dinvincible98/MAE172-Card-shuffler/README.md

# MAE172-Card-shuffler
This is the final project for MAE172 at UC Irvine.For detailed information about CAD design, circuit design and code, please view the final report.
