dinvincible98/MAE172-Card-shuffler/CAD/Assembly/Motor& Roller Assembly.SLDASM

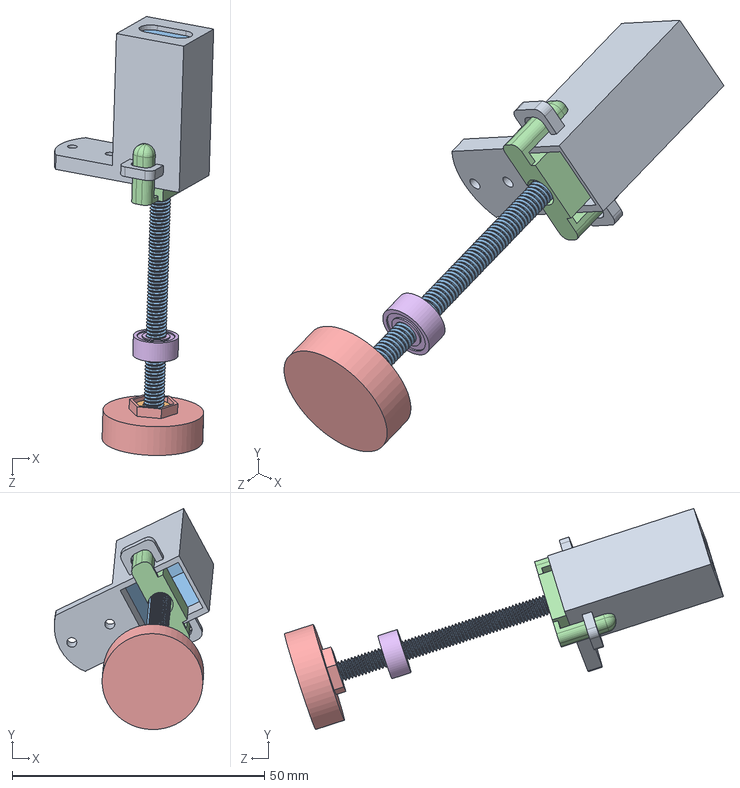
[picture p22: CAD file, 2021-01-10]
CAD/Assembly/Motor& Roller Assembly.SLDASM
31.6 x 43.8 x 87.1 mm
M4 Nut
New Motor
New Motor case2
New Motor enclosure
New Motor roller
Bearing
