dinvincible98/MAE172-Card-shuffler/CAD/Assembly/poker case assembly 2.SLDASM

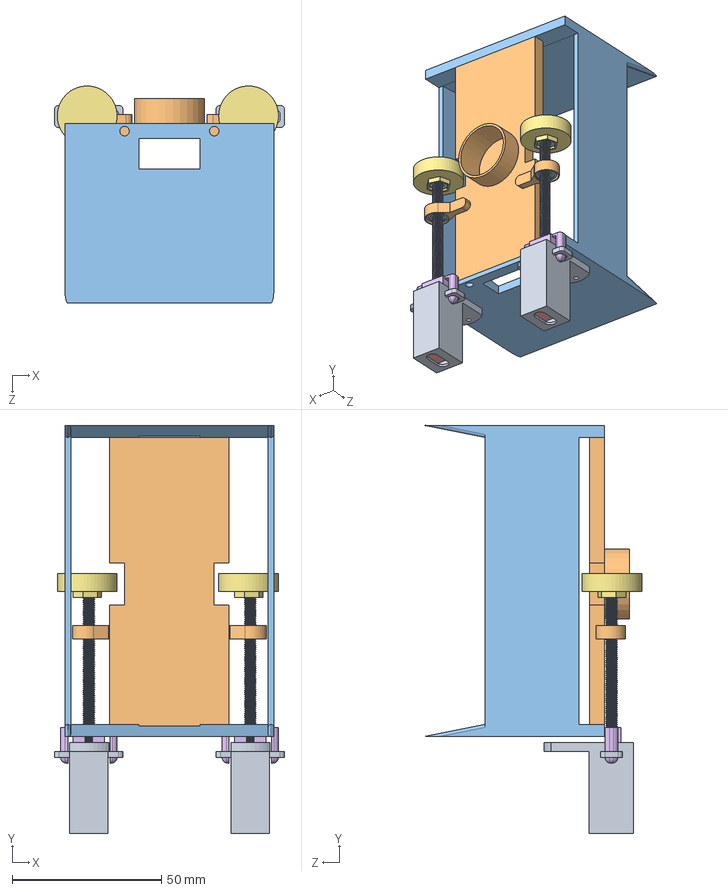
[picture p23: CAD file, 2021-01-10]
CAD/Assembly/poker case assembly 2.SLDASM
77.0 x 136.5 x 72.6 mm
poker case base 1
poker case base 2
M4 Nut x 2
New Motor x 2
New Motor case2 x 2
New Motor enclosure x 2
New Motor roller x 2
Bearing x 2
