dinvincible98/MAE172-Card-shuffler/CAD/Assembly/side platform assembly (right).SLDASM

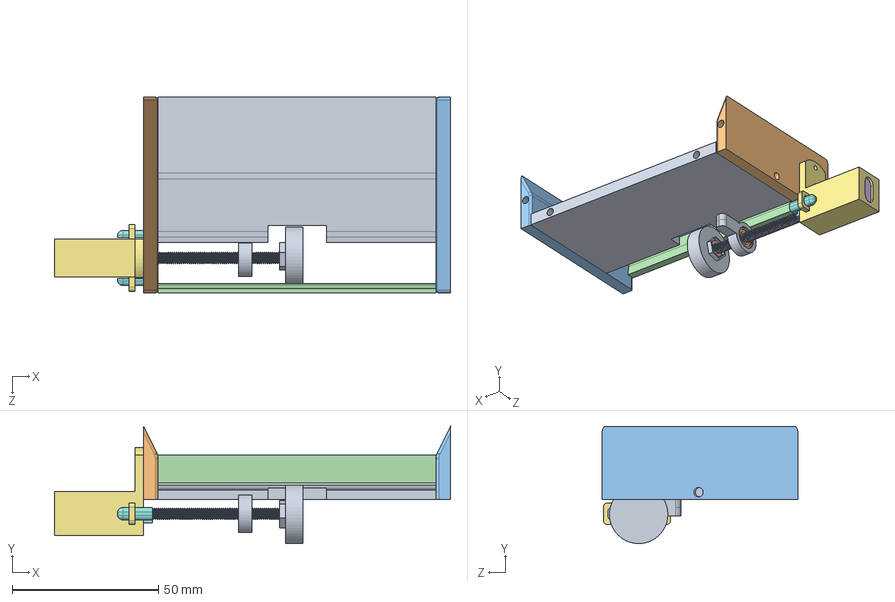
[picture p24: CAD file, 2021-01-10]
CAD/Assembly/side platform assembly (right).SLDASM
135.5 x 40.1 x 67.0 mm
Poker plate (right)
Poker plate2(right)
Poker plate2.2(right)
Poker plate3.1
M4 Nut
New Motor
New Motor case2
New Motor enclosure
New Motor roller
Bearing
