dinvincible98/MAE172-Card-shuffler/CAD/Assembly/base &elevator.SLDASM

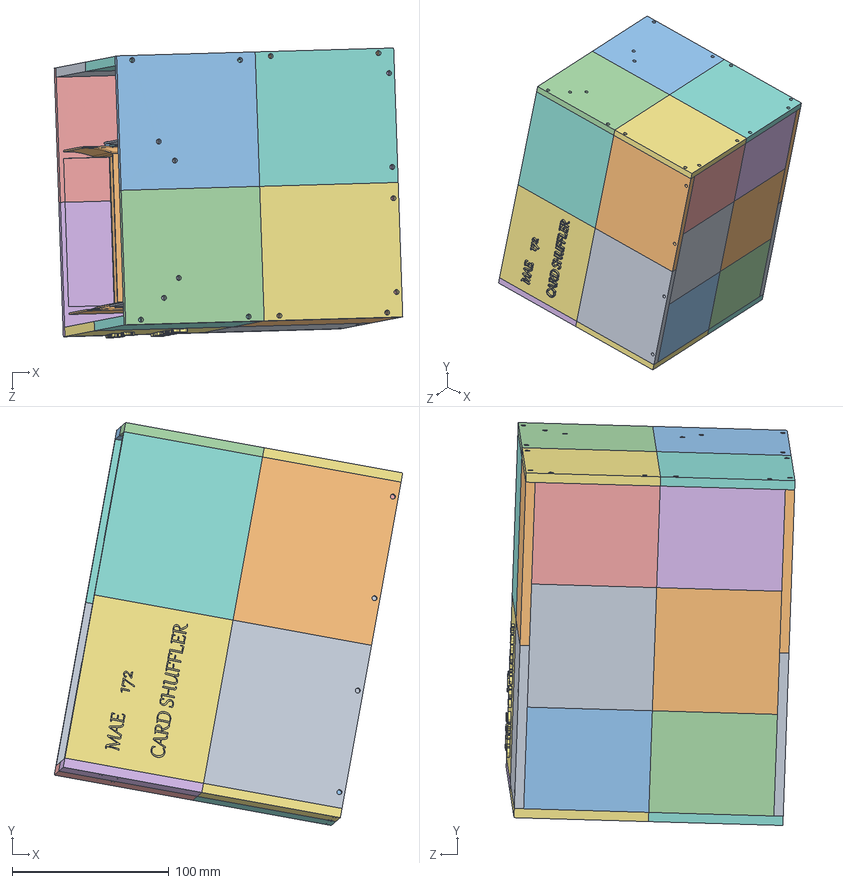
[picture p25: CAD file, 2021-01-10]
CAD/Assembly/base &elevator.SLDASM
222.7 x 257.5 x 185.3 mm
7mm base plate
7mm base plate 2
7mm base plate 3
7mm base plate 4
7mm base plate 5
7mm base plate 6
6mm side plate1 x 2
6mm side plate2 x 2
6mm back plate1 x 2
6mm back plate2( back)
6mm side plate3(right)
6mm side plate4(right)
6mm side plate3
6mm side plate4
6mm back plate3( front)
6mm back plate4 x 2
6mm back plate3( back)
6mm back plate2
rack platform V3
rack base V5
spur gear_am
rack spur rectangular_am
poker case base 1
poker case base 2
M4 Nut x 4
New Motor x 4
New Motor case2 x 4
New Motor enclosure x 4
New Motor roller x 4
Bearing x 4
motor
motor enclosure
right platform
left platform
IRsemsor x 2
