dinvincible98/MAE172-Card-shuffler/CAD/Assembly/poker case assembly.SLDASM

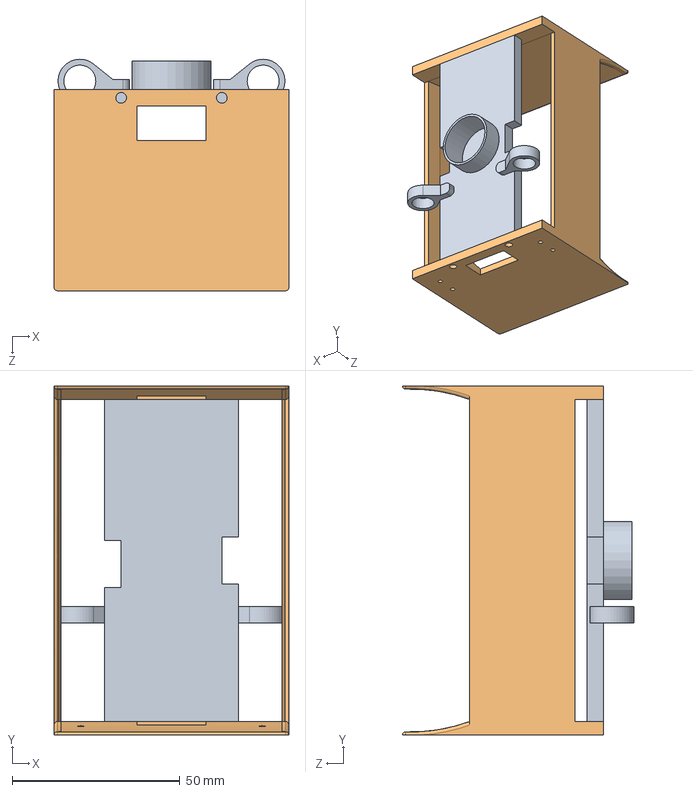
[picture p26: CAD file, 2021-01-10]
CAD/Assembly/poker case assembly.SLDASM
70.0 x 104.0 x 69.0 mm
poker case base 1
poker case base 2
