dinvincible98/MAE172-Card-shuffler/CAD/Assembly/side platform assembly (left).SLDASM

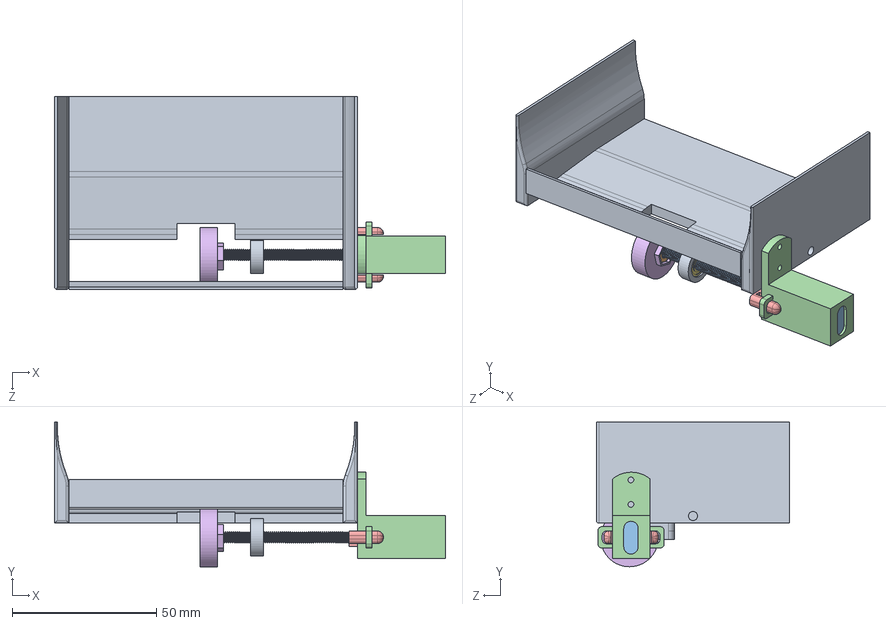
[picture p27: CAD file, 2021-01-10]
CAD/Assembly/side platform assembly (left).SLDASM
135.5 x 50.1 x 67.0 mm
left platform
M4 Nut
New Motor
New Motor case2
New Motor enclosure
New Motor roller
Bearing
