dinvincible98/MAE172-Card-shuffler/CAD/Assembly/right platform assembly (right).SLDASM

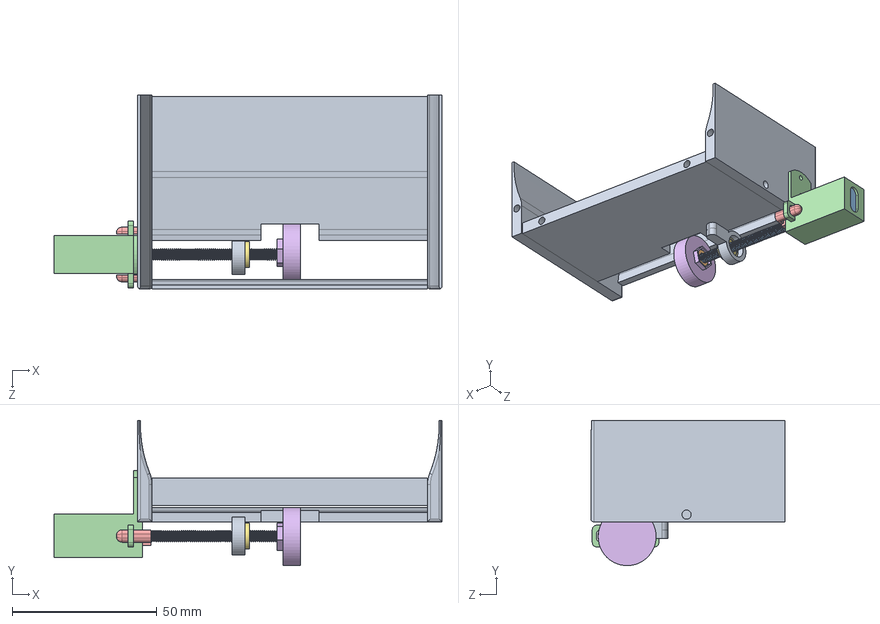
[picture p28: CAD file, 2021-01-10]
CAD/Assembly/right platform assembly (right).SLDASM
133.8 x 50.1 x 67.0 mm
right platform
M4 Nut
New Motor
New Motor case2
New Motor enclosure
New Motor roller
Bearing
