dinvincible98/MAE172-Card-shuffler/CAD/Assembly/1.SLDASM

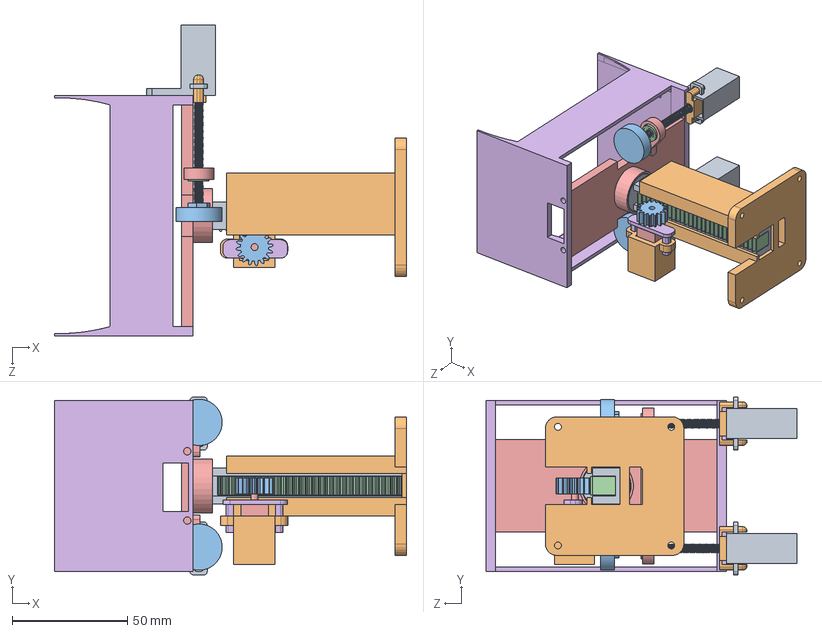
[picture p29: CAD file, 2021-01-10]
CAD/Assembly/1.SLDASM
152.4 x 77.0 x 134.5 mm
rack platform V3
rack base V5
spur gear_am
rack spur rectangular_am
poker case base 1
poker case base 2
M4 Nut x 2
New Motor x 2
New Motor case2 x 2
New Motor enclosure x 2
New Motor roller x 2
Bearing x 2
motor
motor enclosure
