dinvincible98/MAE172-Card-shuffler/CAD/Assembly/Elevator assembly.SLDASM

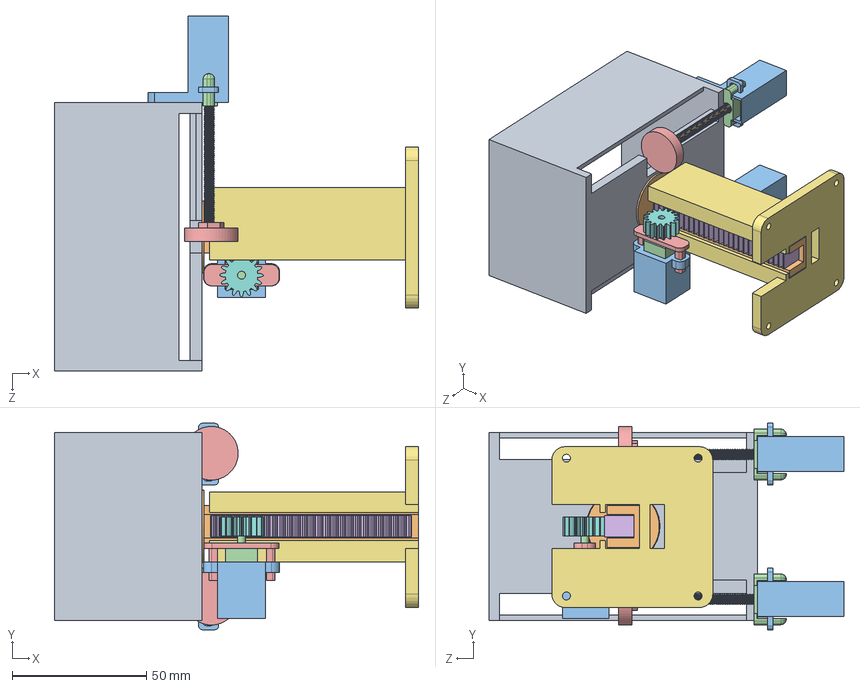
[picture p30: CAD file, 2021-01-10]
CAD/Assembly/Elevator assembly.SLDASM
135.8 x 77.0 x 132.3 mm
Poker case v3
rack platform V3
motor platform
motor
motor enclosure
rack spur rectangular_am
rack base V3
spur gear_am
M4 Nut x 2
New Motor x 2
New Motor case x 2
New Motor enclosure x 2
New Motor roller x 2
