dinvincible98/MAE172-Card-shuffler/CAD/Assembly/roller assembly.SLDASM

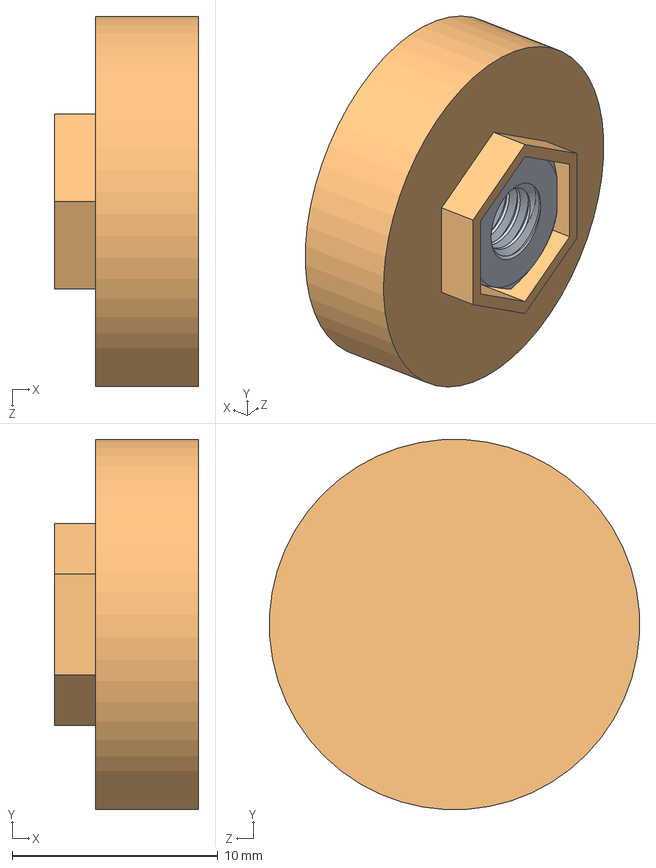
[picture p31: CAD file, 2021-01-10]
CAD/Assembly/roller assembly.SLDASM
7.00 x 18.0 x 18.0 mm
M4 Nut
New Motor roller
