dinvincible98/MAE172-Card-shuffler/CAD/Parts/Poker case v3.SLDPRT

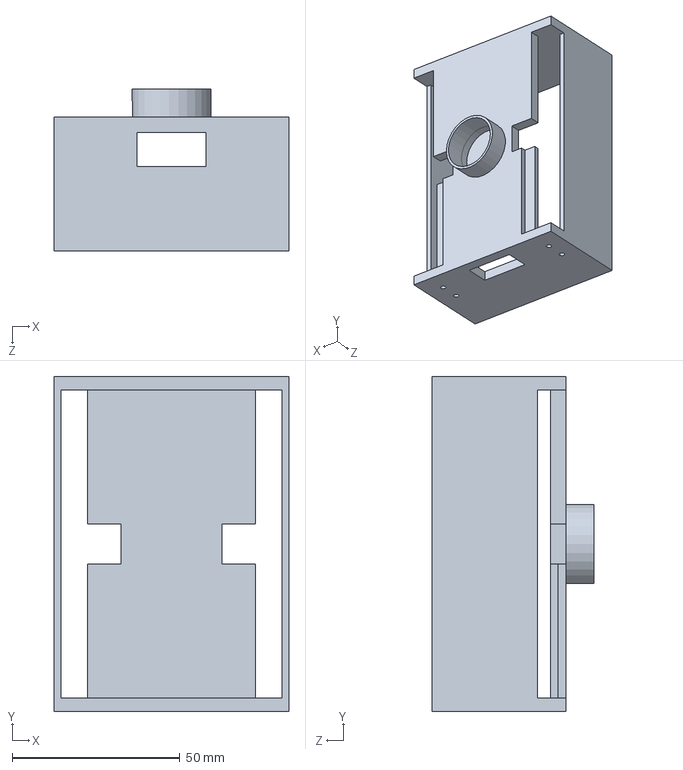
[picture p32: CAD file, 2021-01-10]
CAD/Parts/Poker case v3.SLDPRT
70.0 x 100.0 x 48.5 mm
