dinvincible98/MAE172-Card-shuffler/CAD/Parts/bearing case2.SLDPRT

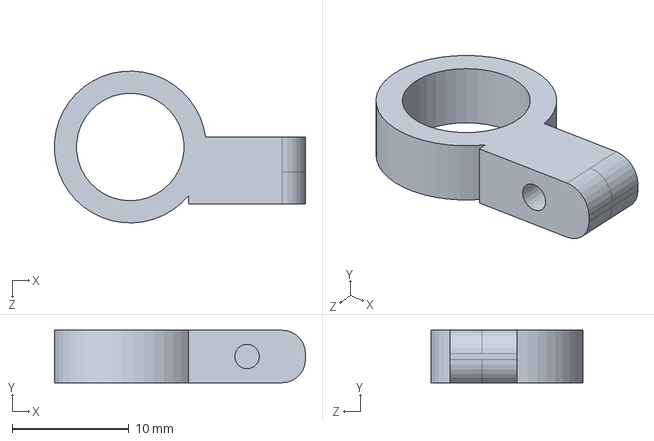
[picture p33: CAD file, 2021-01-10]
CAD/Parts/bearing case2.SLDPRT
21.5 x 4.50 x 13.0 mm
