dinvincible98/MAE172-Card-shuffler/CAD/Assembly/New Motor roller.STL

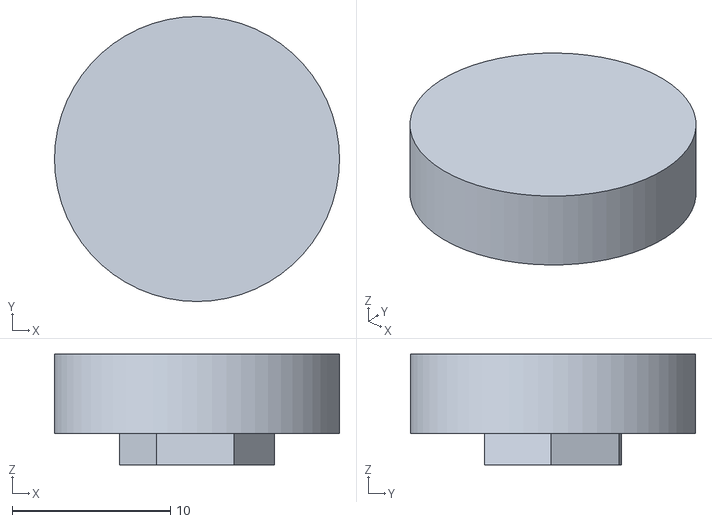
[picture p34: CAD file, 2021-01-10]
CAD/Assembly/New Motor roller.STL
18.0 x 18.0 x 7.00
