dinvincible98/MAE172-Card-shuffler/CAD/Parts/rack base V5.SLDPRT

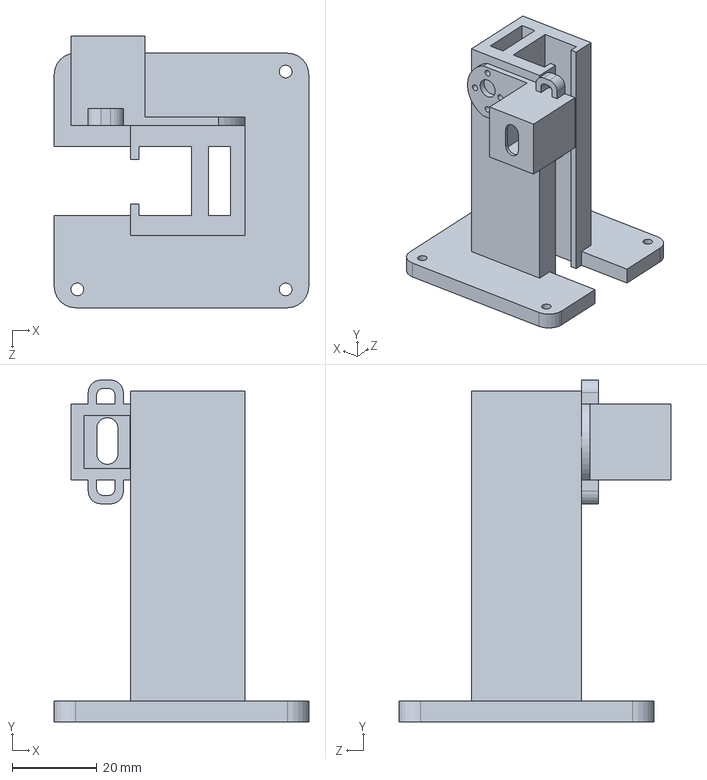
[picture p35: CAD file, 2021-01-10]
CAD/Parts/rack base V5.SLDPRT
60.0 x 80.6 x 64.0 mm
