dinvincible98/MAE172-Card-shuffler/CAD/Parts/rack platform V3.SLDPRT

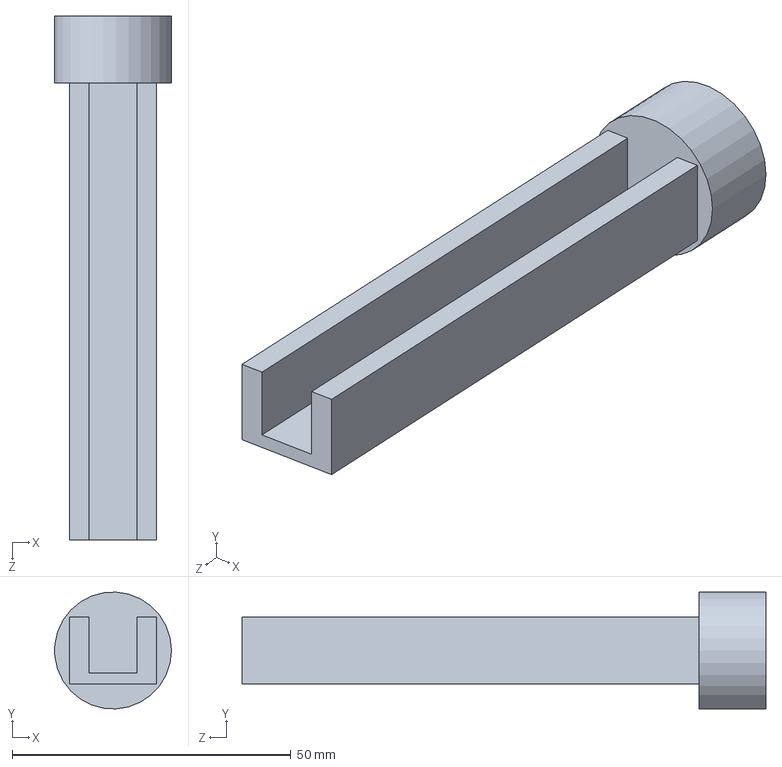
[picture p36: CAD file, 2021-01-10]
CAD/Parts/rack platform V3.SLDPRT
21.0 x 21.0 x 94.0 mm
