dinvincible98/MAE172-Card-shuffler/CAD/Parts/New Motor case.SLDPRT

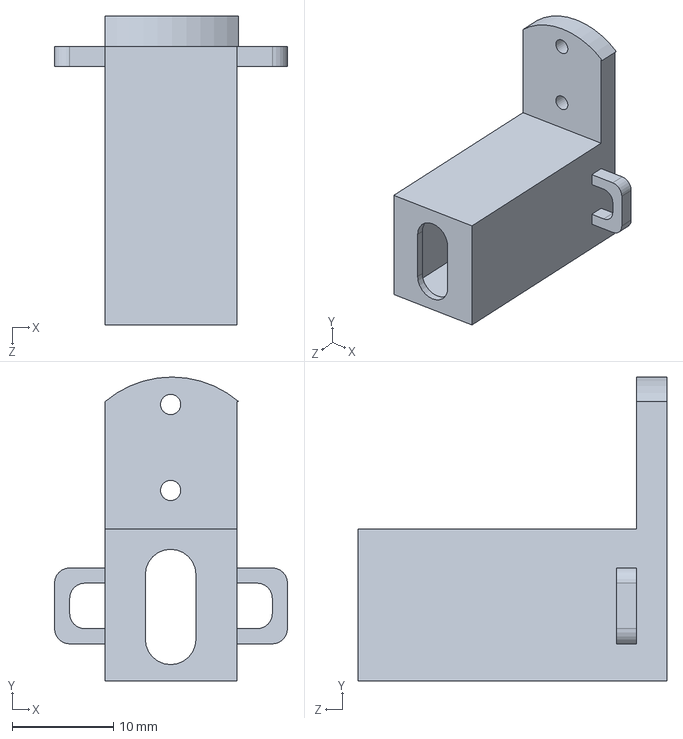
[picture p37: CAD file, 2021-01-10]
CAD/Parts/New Motor case.SLDPRT
23.0 x 30.0 x 30.5 mm
