dinvincible98/MAE172-Card-shuffler/CAD/Parts/poker case base 2.SLDPRT

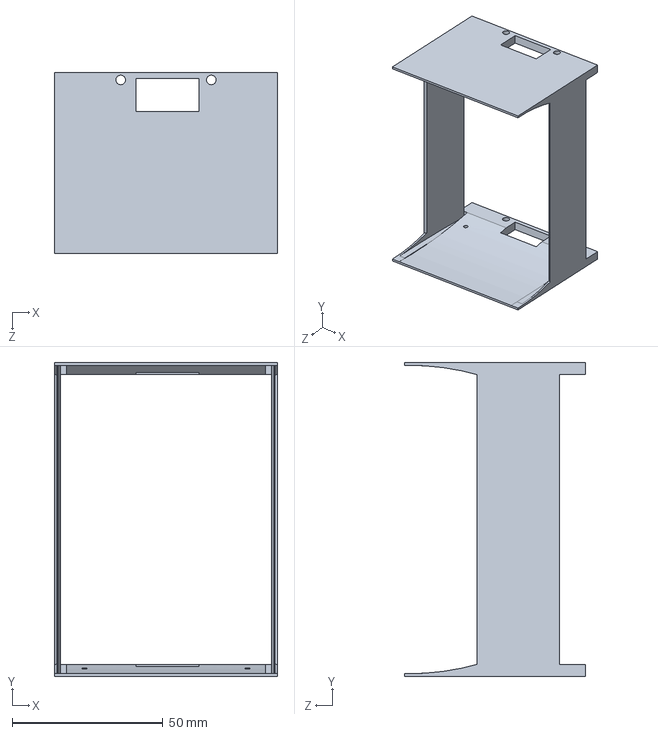
[picture p38: CAD file, 2021-01-10]
CAD/Parts/poker case base 2.SLDPRT
74.0 x 104.0 x 60.0 mm
