dinvincible98/MAE172-Card-shuffler/CAD/Parts/rack.SLDPRT

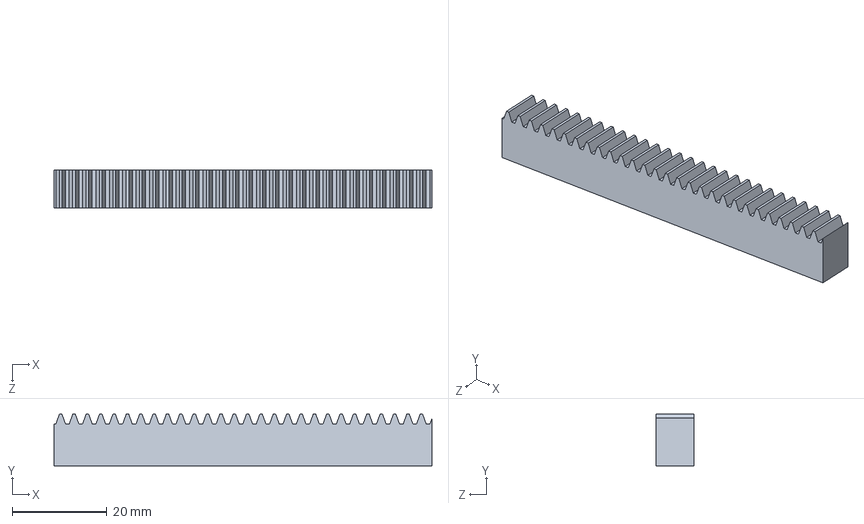
[picture p39: CAD file, 2021-01-10]
CAD/Parts/rack.SLDPRT
80.0 x 10.9 x 8.00 mm
