dinvincible98/MAE172-Card-shuffler/CAD/Parts/IRsemsor.SLDPRT

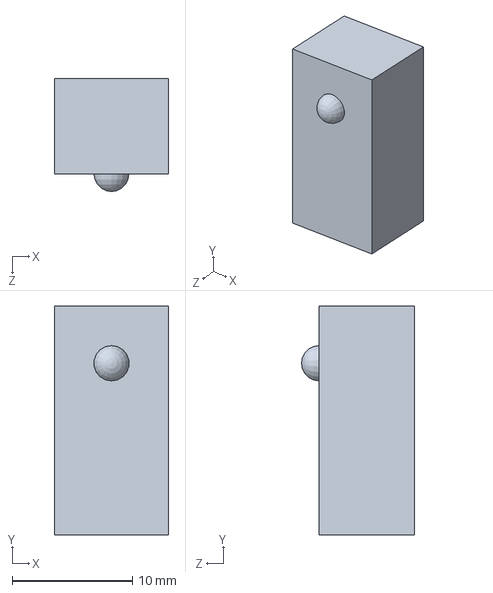
[picture p40: CAD file, 2021-01-10]
CAD/Parts/IRsemsor.SLDPRT
9.53 x 19.1 x 9.41 mm
