dinvincible98/MAE172-Card-shuffler/CAD/Parts/poker case base 1.SLDPRT

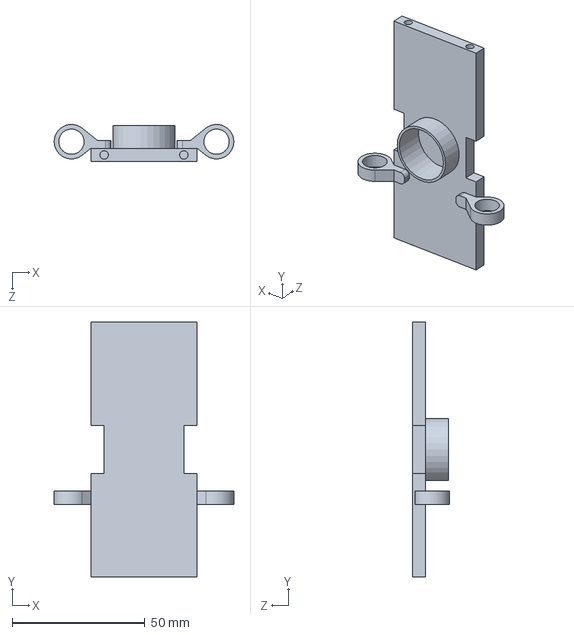
[picture p41: CAD file, 2021-01-10]
CAD/Parts/poker case base 1.SLDPRT
67.6 x 96.0 x 14.0 mm
