dinvincible98/MAE172-Card-shuffler/CAD/Parts/motor enclosure.SLDPRT

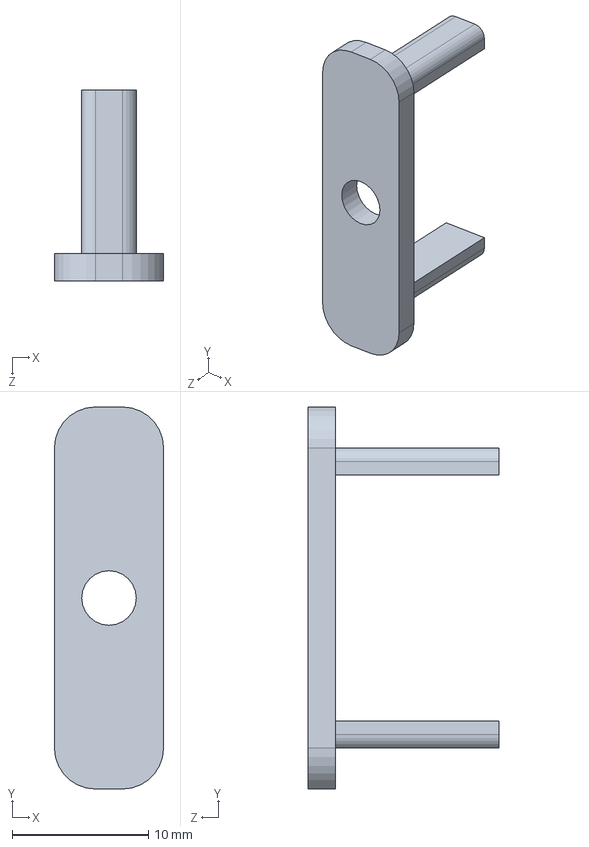
[picture p42: CAD file, 2021-01-10]
CAD/Parts/motor enclosure.SLDPRT
8.00 x 28.0 x 14.0 mm
