dinvincible98/MAE172-Card-shuffler/CAD/Parts/New Motor.SLDPRT

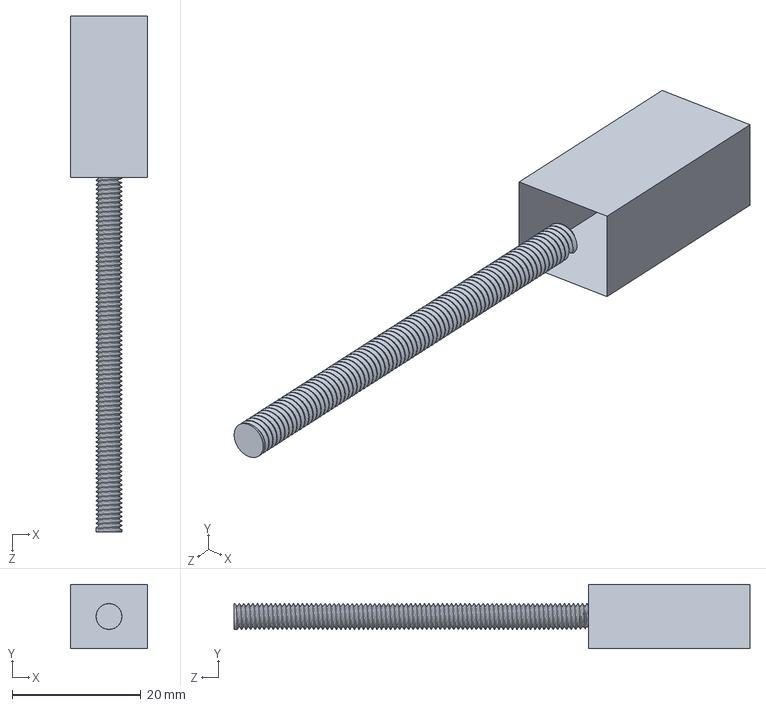
[picture p43: CAD file, 2021-01-10]
CAD/Parts/New Motor.SLDPRT
12.0 x 10.0 x 80.0 mm
