dinvincible98/MAE172-Card-shuffler/CAD/Parts/New Motor roller.SLDPRT

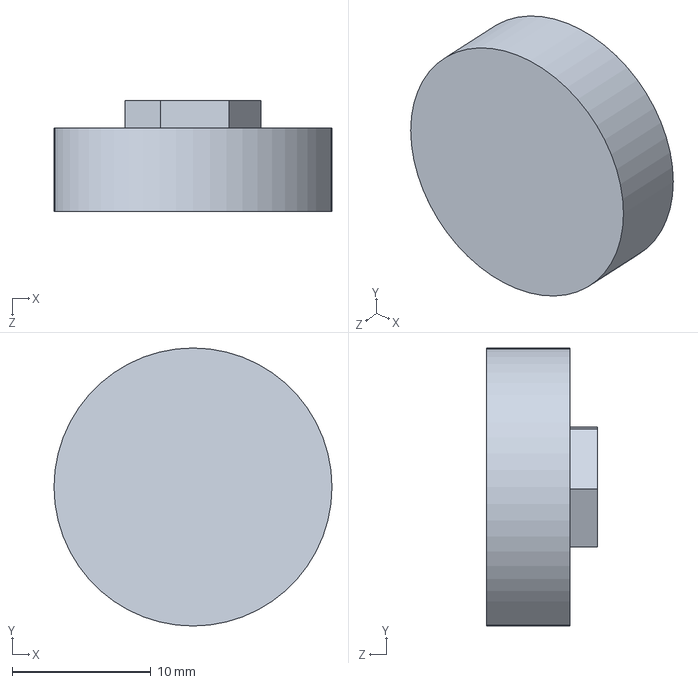
[picture p44: CAD file, 2021-01-10]
CAD/Parts/New Motor roller.SLDPRT
20.0 x 20.0 x 8.00 mm
