dinvincible98/MAE172-Card-shuffler/CAD/Parts/bearing case.SLDPRT

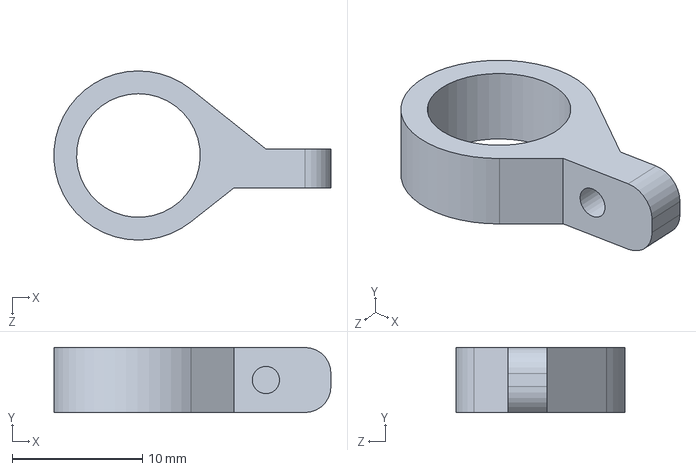
[picture p45: CAD file, 2021-01-10]
CAD/Parts/bearing case.SLDPRT
21.3 x 5.00 x 13.0 mm
