dinvincible98/MAE172-Card-shuffler/CAD/Parts/New Motor enclosure.SLDPRT

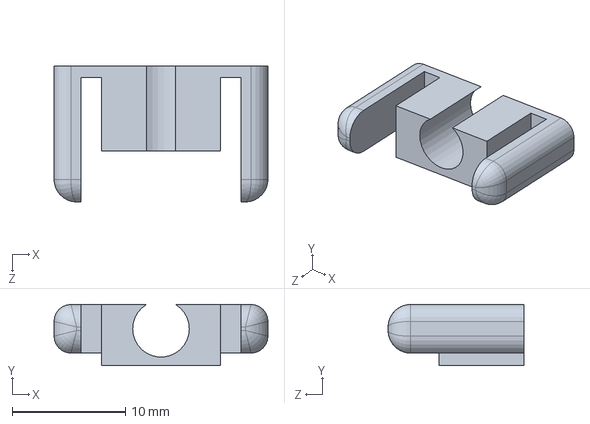
[picture p46: CAD file, 2021-01-10]
CAD/Parts/New Motor enclosure.SLDPRT
18.9 x 5.40 x 12.0 mm
