dinvincible98/MAE172-Card-shuffler/CAD/Parts/motor platform.SLDPRT

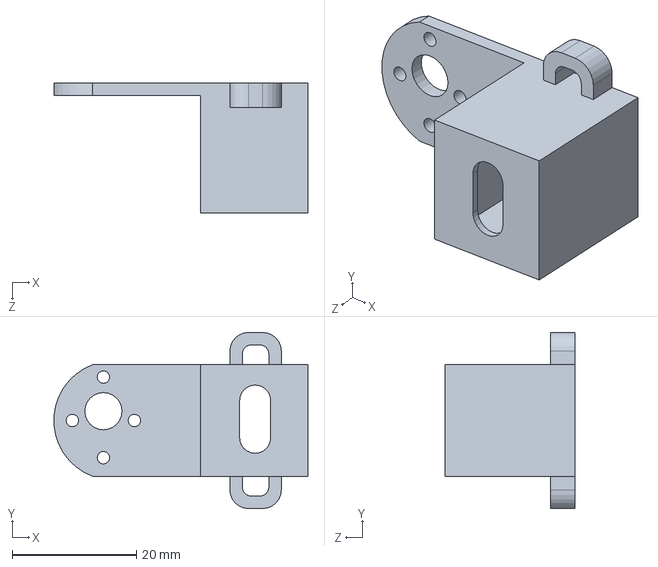
[picture p47: CAD file, 2021-01-10]
CAD/Parts/motor platform.SLDPRT
41.0 x 28.4 x 21.0 mm
