dinvincible98/MAE172-Card-shuffler/(list of files, cad)

Other CAD files:
CAD/Parts/New Motor case2.SLDPRT
CAD/Parts/M4 Nut.SLDPRT
CAD/Parts/rack base V3.SLDPRT
CAD/Parts/rack base V4.SLDPRT
